Julespeak/the-spirit-board/CHANGELOG.md

# Changelog

## [1.0.0] - 2025-10-26
- First public release of the S.P.I.R.I.T. Board
- Added KiCad source files, schematic, BOM, and licensing
- Added README with reference links and photos
