Julespeak/the-spirit-board/hardware/outputs/the-spirit-board.pdf

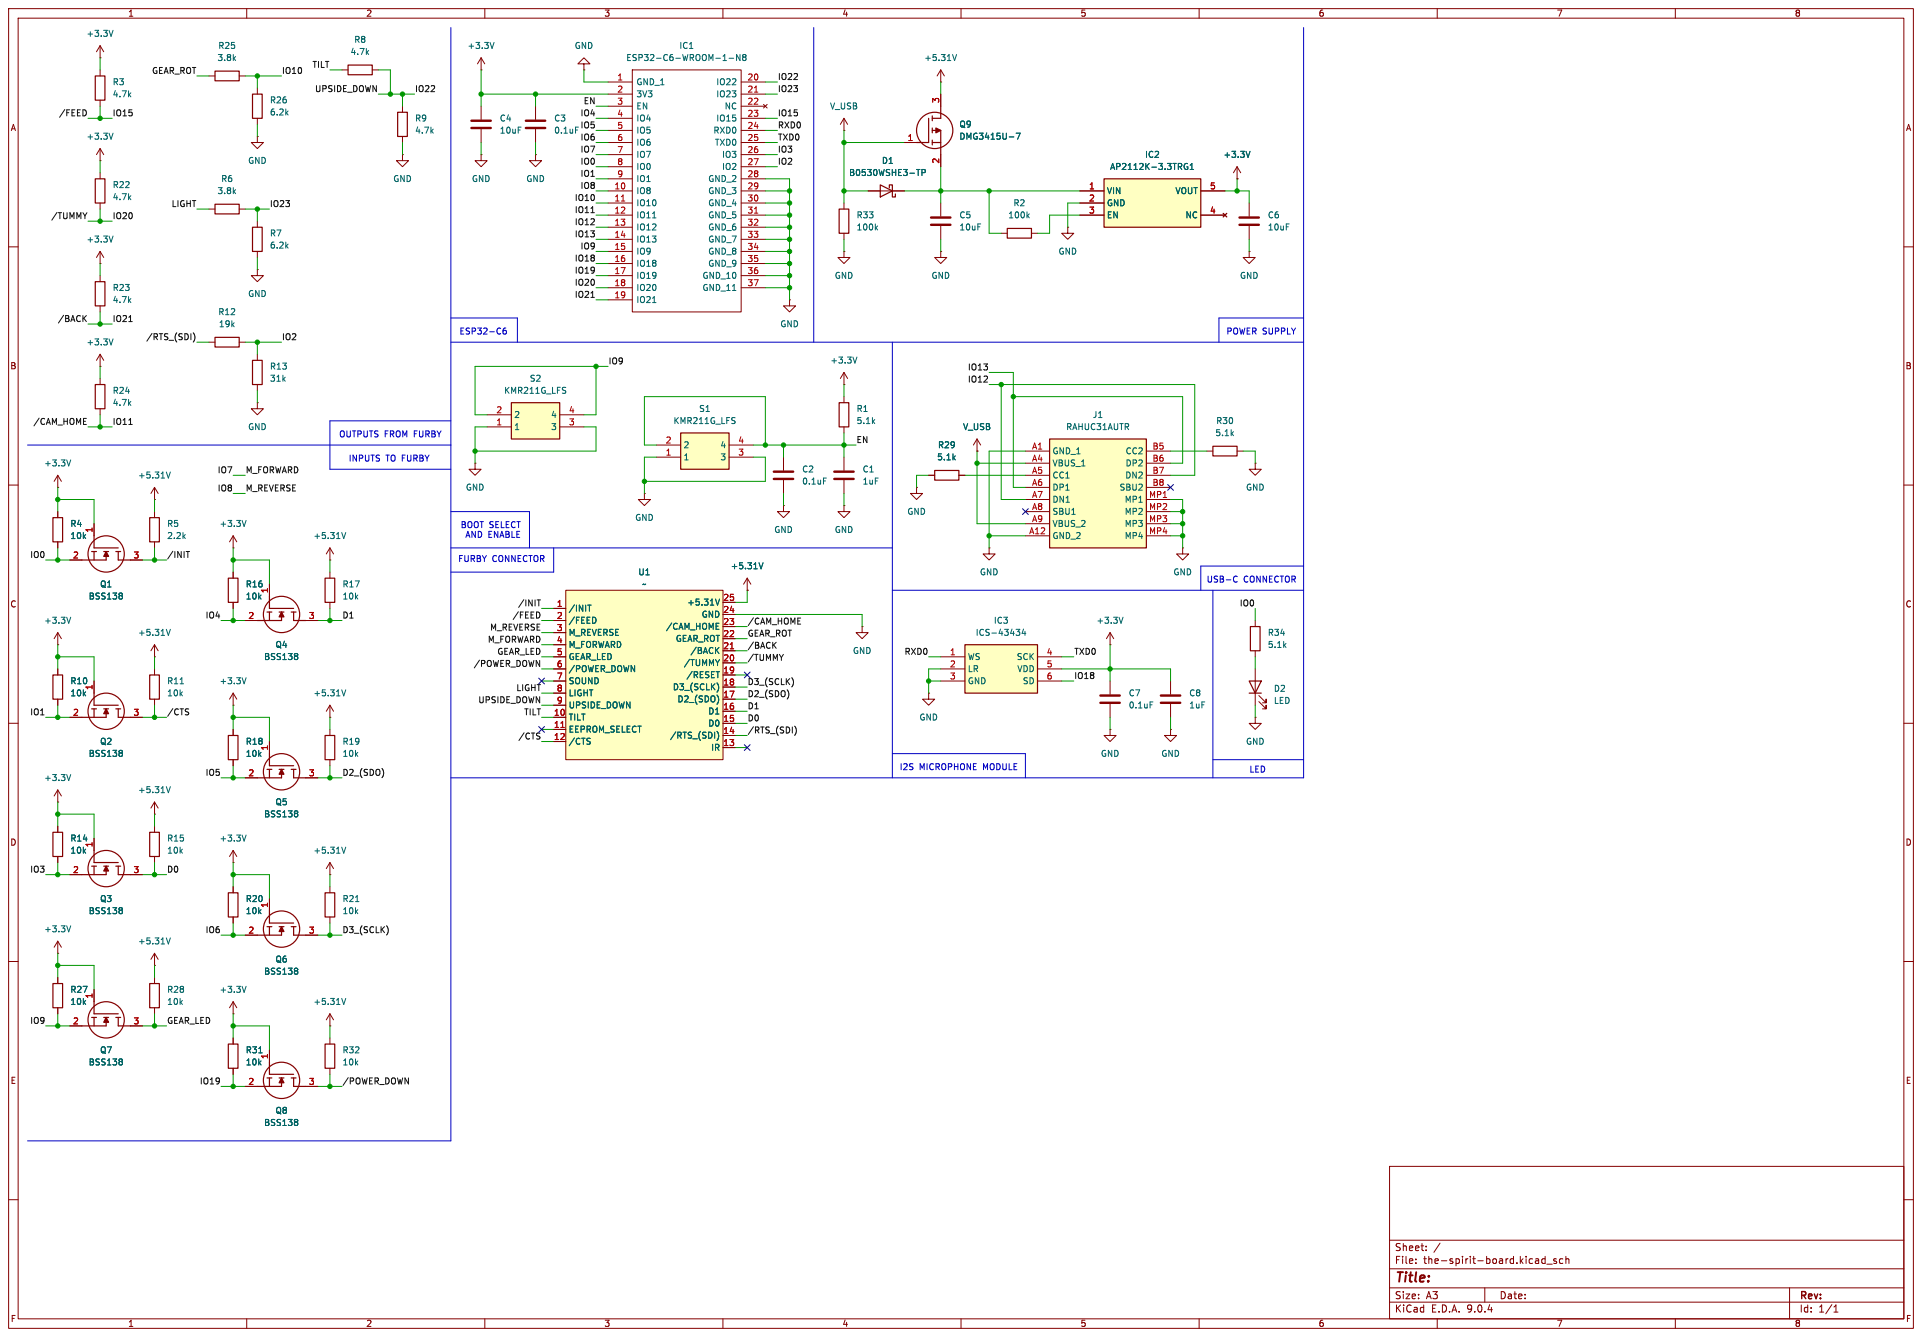
[picture p3: page 1]

BOOT SELECT AND ENABLE R20

Id: 1/1 Title: File: the-spirit-board.kicad_sch Sheet: /
