Julespeak/the-spirit-board/hardware/the-spirit-board.kicad_pcb

## KiCad design hardware/the-spirit-board.kicad_pcb (2025-10-21)

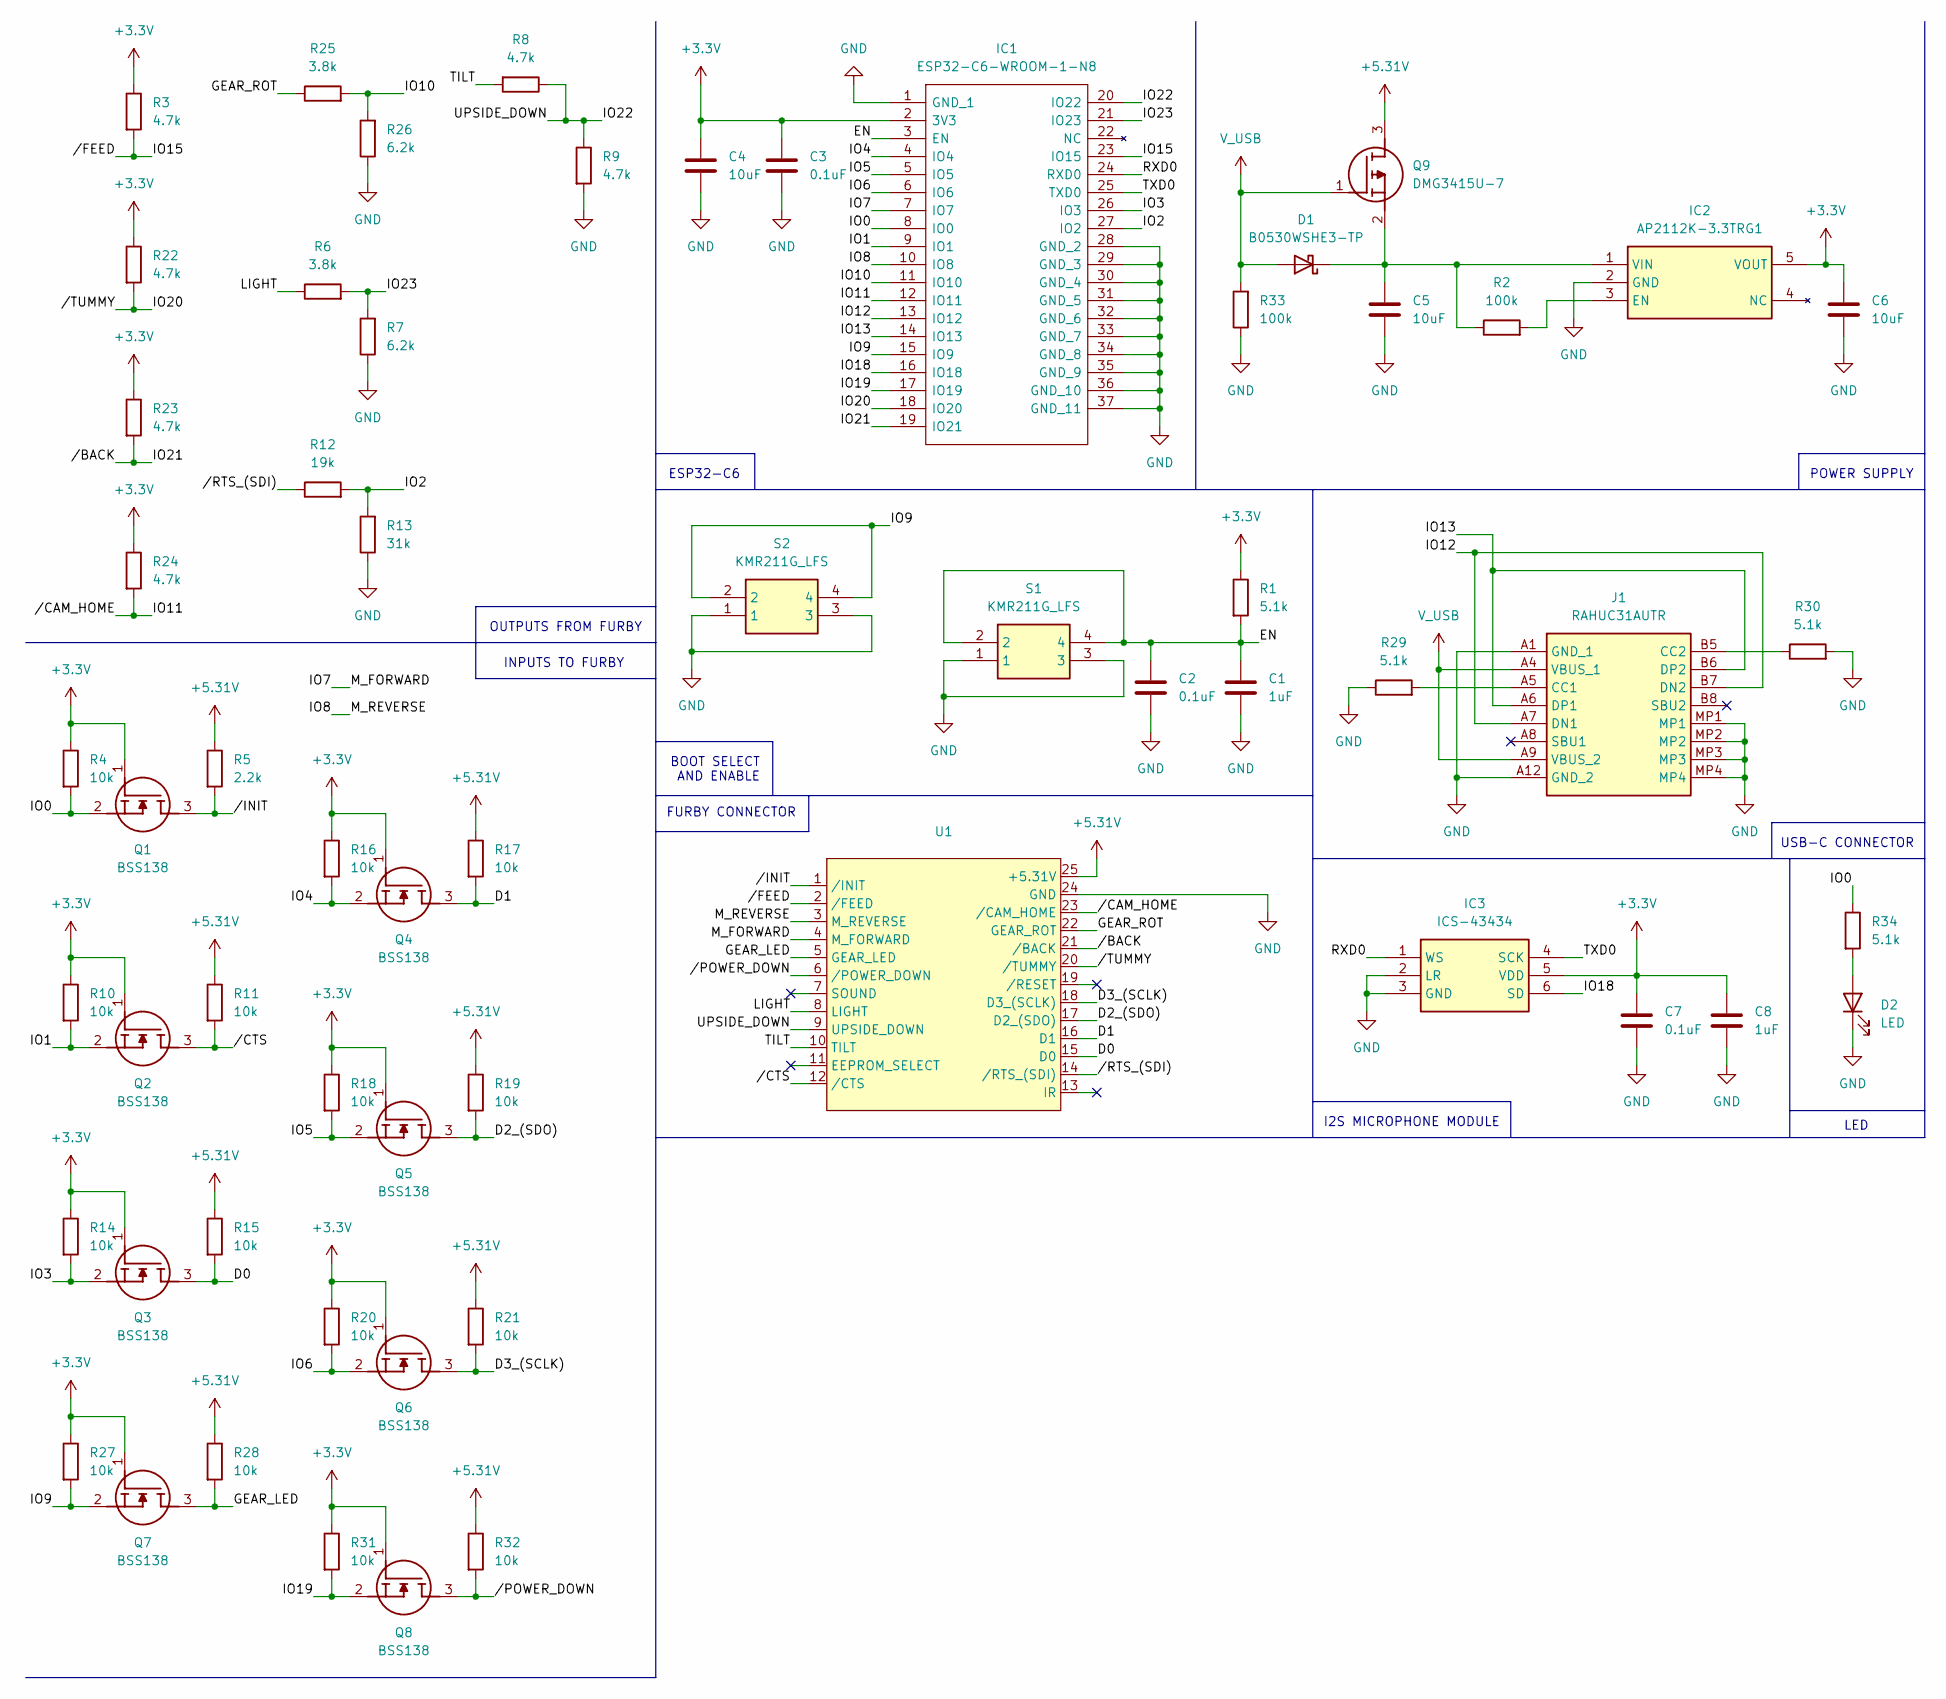
[picture p4: schematic the-spirit-board.kicad_sch]

Parts:
C1, C8: 1uF; C_0603_1608Metric; JLCPCB Part Number C15849
C2, C3: 0.1uF; C_0402_1005Metric; JLCPCB Part Number C307331
C4, C5, C6: 10uF; C_0805_2012Metric; JLCPCB Part Number C440198
C7: 0.1uF; C_0603_1608Metric; JLCPCB Part Number C14663
D1: B0530WSHE3-TP; D_SOD-323; JLCPCB Part Number C3759178
D2: LED; LED_0603_1608Metric; JLCPCB Part Number C2286
IC1: ESP32-C6-WROOM-1-N8; ESP32C6WROOM1N8; Mouser Part Number 356-ESP32C6WROOM1N8
IC2: AP2112K-3.3TRG1; SOT95P285X140-5N; Mouser Part Number 621-AP2112K-3.3TRG1
IC3: ICS-43434; ICS43434; Mouser Part Number 410-ICS-43434
J1: RAHUC31AUTR; Manufacturer_Part_Number RAHUC31AUTR; JLCPCB Part Number C21350227
Q1, Q2, Q3, Q4, Q5, Q6, Q7, Q8: BSS138; SOT95P240X120-3N; Mouser Part Number 512-BSS138
Q9: DMG3415U-7; SOT96P240X110-3N; Mouser Part Number 621-DMG3415U-7
R1, R29, R30, R34: 5.1k; R_0603_1608Metric; JLCPCB Part Number C23186
R2, R33: 100k; R_0603_1608Metric; JLCPCB Part Number C25803
R3, R8, R9, R22, R23, R24: 4.7k; R_0603_1608Metric; JLCPCB Part Number C23162
R4, R10, R11, R14, R15, R16, R17, R18, R19, R20, R21, R27, R28, R31, R32: 10k; R_0603_1608Metric; JLCPCB Part Number C25804
R5: 2.2k; R_0603_1608Metric; JLCPCB Part Number C4190
R6, R25: 3.8k; R_0603_1608Metric; JLCPCB Part Number C23018
R7, R26: 6.2k; R_0603_1608Metric; JLCPCB Part Number C4260
R12: 19k; R_0603_1608Metric; JLCPCB Part Number C25810
R13: 31k; R_0603_1608Metric; JLCPCB Part Number C22984
S1, S2: KMR211G_LFS; KMR_2; Mouser Part Number 611-KMR211G-LFS
U1: FURBY; JLCPCB Part Number N/A

Connections:
+3.3V: C3.1, C4.1, C6.2, C7.2, C8.2, IC1.2 (3V3), IC2.5 (VOUT), IC3.5 (VDD), Q1.1 (G), Q2.1 (G), Q3.1 (G), Q4.1 (G), Q5.1 (G), Q6.1 (G), Q7.1 (G), Q8.1 (G), R1.1, R3.1, R4.1, R10.1, R14.1, R16.1, R18.1, R20.1, R22.1, R23.1, R24.1, R27.1, R31.1
+5.31V: Q9.3 (D), R5.1, R11.1, R15.1, R17.1, R19.1, R21.1, R28.1, R32.1, U1.25 (+5.31V)
/D0: Q3.3 (D), R15.2, U1.15 (D0)
/D1: Q4.3 (D), R17.2, U1.16 (D1)
/D2_(SDO): Q5.3 (D), R19.2, U1.17 (D2_(SDO))
/D3_(SCLK): Q6.3 (D), R21.2, U1.18 (D3_(SCLK))
/EN: C1.1, C2.1, IC1.3 (EN), R1.2, S1.2, S1.4
/GEAR_LED: Q7.3 (D), R28.2, U1.5 (GEAR_LED)
/GEAR_ROT: R25.1, U1.22 (GEAR_ROT)
/IO0: IC1.8 (IO0), Q1.2 (S), R4.2, R34.1
/IO1: IC1.9 (IO1), Q2.2 (S), R10.2
/IO2: IC1.27 (IO2), R12.2, R13.2
/IO3: IC1.26 (IO3), Q3.2 (S), R14.2
/IO4: IC1.4 (IO4), Q4.2 (S), R16.2
/IO5: IC1.5 (IO5), Q5.2 (S), R18.2
/IO6: IC1.6 (IO6), Q6.2 (S), R20.2
/IO7: IC1.7 (IO7), U1.4 (M_FORWARD)
/IO8: IC1.10 (IO8), U1.3 (M_REVERSE)
/IO9: IC1.15 (IO9), Q7.2 (S), R27.2, S2.2, S2.4
/IO10: IC1.11 (IO10), R25.2, R26.2
/IO11: IC1.12 (IO11), R24.2, U1.23 (/CAM_HOME)
/IO12: IC1.13 (IO12), J1.A7 (DN1), J1.B7 (DN2)
/IO13: IC1.14 (IO13), J1.A6 (DP1), J1.B6 (DP2)
/IO15: IC1.23 (IO15), R3.2, U1.2 (/FEED)
/IO18: IC1.16 (IO18), IC3.6 (SD)
/IO19: IC1.17 (IO19), Q8.2 (S), R31.2
/IO20: IC1.18 (IO20), R22.2, U1.20 (/TUMMY)
/IO21: IC1.19 (IO21), R23.2, U1.21 (/BACK)
/IO22: IC1.20 (IO22), R8.1, R9.1, U1.9 (UPSIDE_DOWN)
/IO23: IC1.21 (IO23), R6.2, R7.2
/LIGHT: R6.1, U1.8 (LIGHT)
/RXD0: IC1.24 (RXD0), IC3.1 (WS)
/TILT: R8.2, U1.10 (TILT)
/TXD0: IC1.25 (TXD0), IC3.4 (SCK)
//CTS: Q2.3 (D), R11.2, U1.12 (/CTS)
//INIT: Q1.3 (D), R5.2, U1.1 (/INIT)
//POWER_DOWN: Q8.3 (D), R32.2, U1.6 (/POWER_DOWN)
//RTS_(SDI): R12.1, U1.14 (/RTS_(SDI))
GND: C1.2, C2.2, C3.2, C4.2, C5.1, C6.1, C7.1, C8.1, D2.1 (K), IC1.1 (GND_1), IC1.28 (GND_2), IC1.29 (GND_3), IC1.30 (GND_4), IC1.31 (GND_5), IC1.32 (GND_6), IC1.33 (GND_7), IC1.34 (GND_8), IC1.35 (GND_9), IC1.36 (GND_10), IC1.37 (GND_11), IC2.2 (GND), IC3.2 (LR), IC3.3 (GND), J1.A1 (GND_1), J1.A12 (GND_2), J1.MP1, J1.MP2, J1.MP3, J1.MP4, R7.1, R9.2, R13.1, R26.1, R29.1, R30.2, R33.1, S1.1, S1.3, S2.1, S2.3, U1.24 (GND)
unnamed: C5.2, D1.1 (K), IC2.1 (VIN), Q9.2 (S), R2.1
unnamed: D2.2 (A), R34.2
unnamed: IC2.3 (EN), R2.2
unnamed: J1.A5 (CC1), R29.2
unnamed: J1.B5 (CC2), R30.1
V_USB: D1.2 (A), J1.A4 (VBUS_1), J1.A9 (VBUS_2), Q9.1 (G), R33.2

Notes on the sheet:
I2S MICROPHONE MODULE
FURBY CONNECTOR
POWER SUPPLY
LED
INPUTS TO FURBY
BOOT SELECT AND ENABLE
ESP32-C6
USB-C CONNECTOR
OUTPUTS FROM FURBY

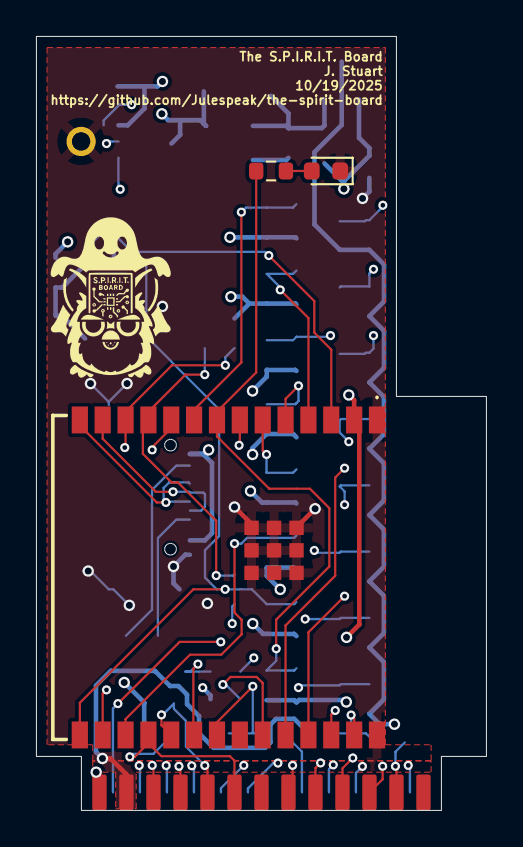
[picture p5: board the-spirit-board.kicad_pcb from above]

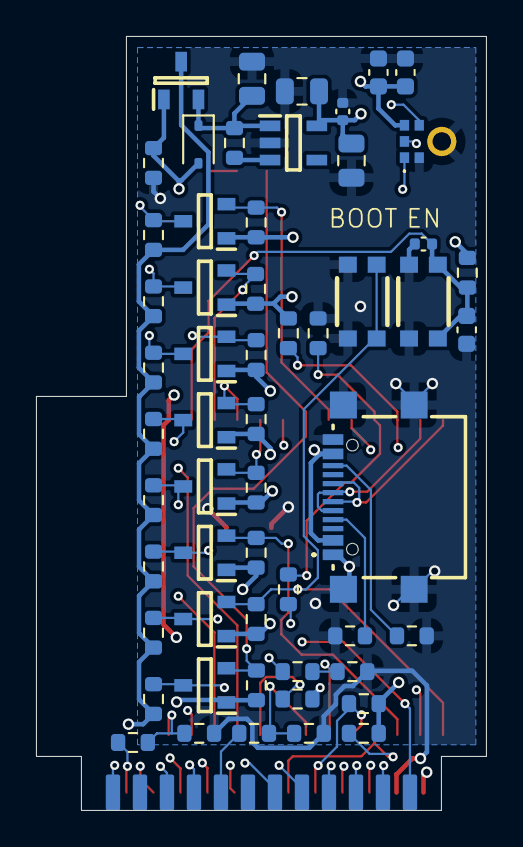
[picture p6: board the-spirit-board.kicad_pcb from below]

Board: 4 copper layers, 25.0 x 43.0 mm, 60 parts (56 on the bottom side), 45 nets.
