Julespeak/the-spirit-board/software/spirit_board.py

"""
Spirit Board Python Library

This library provides a Python interface for communicating with the Spirit Board
invoker firmware running on an ESP32. The Spirit Board is used to communicate
with Furby toys over their proprietary serial bus.

Author: Renegade Science
"""

import socket
import re
from dataclasses import dataclass
from typing import Tuple, List, Optional, Dict


# =========================
# EVENT TIMELINE TYPES
# =========================

@dataclass
class TimelineEvent:
    """
    Represents a single event in the Spirit Board timeline.

    Attributes:
        event_type: Event type code (1-9)
        event_name: Human-readable event name
        timestamp_us: Absolute timestamp in microseconds since firmware boot
        data: Event-specific data (nibble value for DATA_NIBBLE events)
    """
    event_type: int
    event_name: str
    timestamp_us: int
    data: Optional[int] = None

    def relative_time_ms(self, t0_us: int) -> float:
        """Get time relative to reference timestamp in milliseconds."""
        return (self.timestamp_us - t0_us) / 1000.0


# Event type constants matching firmware
EVENT_RTS_RISING = 0x01
EVENT_RTS_FALLING = 0x02
EVENT_CTS_RISING = 0x03
EVENT_CTS_FALLING = 0x04
EVENT_DATA_NIBBLE = 0x05
EVENT_MOTOR_FWD_ON = 0x06
EVENT_MOTOR_FWD_OFF = 0x07
EVENT_MOTOR_BWD_ON = 0x08
EVENT_MOTOR_BWD_OFF = 0x09

EVENT_NAMES = {
    EVENT_RTS_RISING: "RTS_RISE",
    EVENT_RTS_FALLING: "RTS_FALL",
    EVENT_CTS_RISING: "CTS_RISE",
    EVENT_CTS_FALLING: "CTS_FALL",
    EVENT_DATA_NIBBLE: "DATA",
    EVENT_MOTOR_FWD_ON: "MOTOR_FWD+",
    EVENT_MOTOR_FWD_OFF: "MOTOR_FWD-",
    EVENT_MOTOR_BWD_ON: "MOTOR_BWD+",
    EVENT_MOTOR_BWD_OFF: "MOTOR_BWD-",
}


class SpiritBoard:
    """
    A high-level interface for controlling the Spirit Board invoker firmware.

    The Spirit Board acts as a bridge between modern computers and the Furby
    serial bus, allowing you to send commands and control motor operations.

    Attributes:
        host (str): IP address of the ESP32 running the invoker firmware
        port (int): TCP port number (default: 5000)
        timeout (float): Socket timeout in seconds (default: 5.0)
    """

    DEFAULT_PORT = 5000
    DEFAULT_TIMEOUT = 5.0

    def __init__(self, host: str, port: int = DEFAULT_PORT, timeout: float = DEFAULT_TIMEOUT):
        """
        Initialize a Spirit Board connection.

        Args:
            host: IP address of the ESP32 (e.g., "192.168.1.100")
            port: TCP port number (default: 5000)
            timeout: Socket timeout in seconds (default: 5.0)
        """
        self.host = host
        self.port = port
        self.timeout = timeout

    def send_hex_command(self, hex_string: str) -> str:
        """
        Send a single hex command to the invoker firmware and return the response.

        This is the low-level command interface. Most users should use the
        higher-level methods like ping(), init_coprocessor(), etc.

        Args:
            hex_string: String containing hex digits (whitespace will be stripped)

        Returns:
            The entire response decoded as ASCII

        Raises:
            ValueError: If hex_string contains invalid characters
            socket.timeout: If the connection times out with no response
        """
        # Remove all whitespace so the firmware only sees hex digits
        cleaned = "".join(hex_string.split())
        if not cleaned:
            raise ValueError("hex_string must contain at least one hex digit")

        # Basic validation: all characters must be hex
        for ch in cleaned:
            if ch not in "0123456789abcdefABCDEF":
                raise ValueError(f"Invalid hex character {ch!r} in {hex_string!r}")

        data = (cleaned + "\n").encode("ascii")

        with socket.socket(socket.AF_INET, socket.SOCK_STREAM) as s:
            s.settimeout(self.timeout)
            s.connect((self.host, self.port))
            s.sendall(data)

            chunks = []
            while True:
                try:
                    chunk = s.recv(1024)
                except socket.timeout:
                    # If we've already got something, return it; otherwise, report timeout
                    if chunks:
                        break
                    return "[NO RESPONSE - socket timeout]"
                if not chunk:
                    break
                chunks.append(chunk)

        resp = b"".join(chunks)
        return resp.decode("ascii", errors="replace").strip()

    def ping(self) -> str:
        """
        Ping the invoker firmware to verify connectivity.

        Returns:
            The ASCII string '31337' if the firmware is responding correctly
        """
        # Control byte 0xFF, no payload
        return self.send_hex_command("FF")

    def init_coprocessor(self) -> str:
        """
        Pulse /INIT low for 10 ms to reset the Furby coprocessor.

        This should be called before sending command sequences to ensure
        the Furby is in a known state.

        Returns:
            Firmware status string
        """
        # Control byte 0x01, no payload required
        return self.send_hex_command("01")

    def send_nibble_stream(self, nibble_hex: str) -> str:
        """
        Send an arbitrary nibble stream to the Furby bus.

        Each character in nibble_hex represents a 4-bit nibble that will be
        sent over the Furby serial bus. This is the primary method for
        sending commands to make the Furby perform actions.

        Args:
            nibble_hex: String of hex digits representing successive 4-bit nibbles
                       (e.g., "F7F347F7F71C000000000000F000FFFFFF")

        Returns:
            Firmware response including nibble echo and timing information
        """
        # Control byte 0x02 + nibble payload
        return self.send_hex_command("02" + nibble_hex)

    def _format_duration_us(self, duration_us: int) -> str:
        """
        Format a duration in microseconds as a 16-hex-digit big-endian 64-bit value.

        Args:
            duration_us: Duration in microseconds (non-negative)

        Returns:
            16 uppercase hex digits (e.g., 1_000_000 -> '00000000000F4240')

        Raises:
            ValueError: If duration_us is negative
        """
        if duration_us < 0:
            raise ValueError("duration_us must be non-negative")
        # Mask to 64 bits and format as 16 uppercase hex digits
        return f"{int(duration_us) & ((1 << 64) - 1):016X}"

    def motor_forward(self, duration_us: int) -> str:
        """
        Drive the Furby motor forward for a specified duration.

        Args:
            duration_us: Duration in microseconds (e.g., 1_000_000 for 1 second)

        Returns:
            Firmware response
        """
        payload = self._format_duration_us(duration_us)
        # Control byte 0x03 + 64-bit duration payload
        return self.send_hex_command("03" + payload)

    def motor_backward(self, duration_us: int) -> str:
        """
        Drive the Furby motor backward for a specified duration.

        Args:
            duration_us: Duration in microseconds (e.g., 1_000_000 for 1 second)

        Returns:
            Firmware response
        """
        payload = self._format_duration_us(duration_us)
        # Control byte 0x04 + 64-bit duration payload
        return self.send_hex_command("04" + payload)

    def get_rts_timing(self) -> str:
        """
        Read the event timeline from the firmware.

        This returns detailed timing information about all bus events during
        the last operation (nibble stream, initialization, etc.). Includes
        RTS/CTS edges, data nibbles, and motor events with microsecond timestamps.

        Use parse_timeline() to convert the response into structured data.

        Returns:
            Timeline data as a string (use parse_timeline() to parse)

        Example:
            >>> events = parse_timeline(board.get_rts_timing())
            >>> print(render_timeline(events, max_events=20))
        """
        # Control byte 0x05, no payload
        return self.send_hex_command("05")


def parse_nibble_echo(response: str) -> Tuple[int, List[int]]:
    """
    Parse a firmware response containing a nibble echo.

    The firmware responds with a line like:
        [NIBBLES] count=24 : 7,F,3,4,1,F,...

    This function extracts the count and nibble values from that response.

    Args:
        response: Firmware response string

    Returns:
        Tuple of (count, list of nibble values as integers)

    Raises:
        ValueError: If the response doesn't contain a valid [NIBBLES] line

    Example:
        >>> parse_nibble_echo("[NIBBLES] count=4 : F,7,3,4")
        (4, [15, 7, 3, 4])
    """
    lines = response.splitlines()
    nib_line = None
    for line in lines:
        if line.startswith("[NIBBLES]"):
            nib_line = line
            break
    if nib_line is None:
        raise ValueError(f"No [NIBBLES] line found in response: {response!r}")

    # Rough parse: extract the 'count=' number and the stuff after ':'
    m = re.search(r"count\s*=\s*(\d+)\s*:\s*(.*)", nib_line)
    if not m:
        raise ValueError(f"Could not parse [NIBBLES] line: {nib_line!r}")

    count = int(m.group(1))
    tail = m.group(2).strip()

    nibs = []
    if tail:
        for part in tail.split(","):
            part = part.strip()
            if not part:
                continue
            # Interpret as hex (so 'F' -> 15, '0' -> 0, 'A' -> 10, etc.)
            nibs.append(int(part, 16))

    return count, nibs


def parse_timeline(response: str) -> List[TimelineEvent]:
    """
    Parse firmware timeline response into structured event list.

    The firmware responds with a line like:
        [TIMELINE] 12 events: 5,0,1A2B3C4D,7;1,0,1A2B3C55;...

    Format for each event:
        - Type,TimestampHi,TimestampLo[,Data]
        - Events separated by semicolons
        - DATA_NIBBLE events include nibble value as 4th field

    Args:
        response: Firmware response string

    Returns:
        List of TimelineEvent objects in chronological order

    Raises:
        ValueError: If response doesn't contain valid [TIMELINE] data

    Example:
        >>> events = parse_timeline(board.get_rts_timing())
        >>> print(f"Captured {len(events)} events")
        >>> print(f"First event: {events[0].event_name} at {events[0].timestamp_us}us")
    """
    lines = response.splitlines()
    timeline_line = None
    for line in lines:
        if line.startswith("[TIMELINE]"):
            timeline_line = line
            break

    if timeline_line is None:
        raise ValueError(f"No [TIMELINE] line found in response: {response!r}")

    # Parse: [TIMELINE] N events: data...
    m = re.search(r'\[TIMELINE\]\s+(\d+)\s+events:\s*(.*)', timeline_line)
    if not m:
        raise ValueError(f"Could not parse [TIMELINE] line: {timeline_line!r}")

    count = int(m.group(1))
    data = m.group(2).strip()

    if count == 0 or data == "none":
        return []

    events = []
    event_strs = data.split(';')

    for evt_str in event_strs:
        evt_str = evt_str.strip()
        if not evt_str:
            continue

        parts = evt_str.split(',')
        if len(parts) < 3:
            raise ValueError(f"Invalid event format: {evt_str!r}")

        # Parse event type
        event_type = int(parts[0], 16)

        # Parse 64-bit timestamp from two 32-bit hex values
        timestamp_hi = int(parts[1], 16)
        timestamp_lo = int(parts[2], 16)
        timestamp_us = (timestamp_hi << 32) | timestamp_lo

        # Parse optional data field (for DATA_NIBBLE events)
        data_val = None
        if len(parts) >= 4:
            data_val = int(parts[3], 16)

        event_name = EVENT_NAMES.get(event_type, f"UNKNOWN_{event_type:02X}")

        events.append(TimelineEvent(
            event_type=event_type,
            event_name=event_name,
            timestamp_us=timestamp_us,
            data=data_val
        ))

    return events


def render_timeline(events: List[TimelineEvent],
                    show_absolute: bool = False,
                    max_events: Optional[int] = None) -> str:
    """
    Render timeline events as human-readable text table.

    Args:
        events: List of TimelineEvent objects
        show_absolute: If True, show absolute timestamps; if False, show relative to first event
        max_events: Maximum number of events to display (None = all)

    Returns:
        Formatted string representation of timeline

    Example:
        >>> events = parse_timeline(board.get_rts_timing())
        >>> print(render_timeline(events, max_events=20))
    """
    if not events:
        return "No events in timeline"

    t0 = events[0].timestamp_us if not show_absolute else 0

    lines = []
    lines.append(f"Timeline: {len(events)} events")
    lines.append("-" * 80)

    if show_absolute:
        lines.append(f"{'Index':<6} {'Time (us)':<20} {'Δt (ms)':<12} {'Event':<15} {'Data'}")
    else:
        lines.append(f"{'Index':<6} {'Δt (ms)':<12} {'Event':<15} {'Data'}")
    lines.append("-" * 80)

    display_events = events[:max_events] if max_events else events
    prev_time = t0

    for idx, evt in enumerate(display_events):
        rel_time_ms = (evt.timestamp_us - t0) / 1000.0
        delta_ms = (evt.timestamp_us - prev_time) / 1000.0

        data_str = ""
        if evt.event_type == EVENT_DATA_NIBBLE and evt.data is not None:
            data_str = f"0x{evt.data:X}"

        if show_absolute:
            lines.append(f"{idx:<6} {evt.timestamp_us:<20} {delta_ms:<12.3f} {evt.event_name:<15} {data_str}")
        else:
            lines.append(f"{idx:<6} {rel_time_ms:<12.3f} {evt.event_name:<15} {data_str}")

        prev_time = evt.timestamp_us

    if max_events and len(events) > max_events:
        lines.append(f"... ({len(events) - max_events} more events)")

    return "\n".join(lines)


def plot_timeline(events: List[TimelineEvent],
                  title: str = "Spirit Board Event Timeline",
                  figsize: Tuple[int, int] = (14, 8),
                  show_nibbles: bool = True):
    """
    Create matplotlib visualization of timeline events.

    Generates a multi-track timeline showing:
    - RTS signal state over time
    - CTS signal state over time
    - Data nibble values
    - Motor events

    Args:
        events: List of TimelineEvent objects
        title: Plot title
        figsize: Figure size (width, height) in inches
        show_nibbles: If True, display nibble values on data track

    Returns:
        tuple: (figure, axes) matplotlib objects

    Example:
        >>> import matplotlib.pyplot as plt
        >>> events = parse_timeline(board.get_rts_timing())
        >>> fig, axes = plot_timeline(events)
        >>> plt.show()
    """
    try:
        import matplotlib.pyplot as plt
        import matplotlib.patches as mpatches
    except ImportError:
        raise ImportError("matplotlib required for timeline visualization. Install with: pip install matplotlib")

    if not events:
        raise ValueError("No events to plot")

    # Convert to relative time in milliseconds
    t0 = events[0].timestamp_us
    times_ms = [(e.timestamp_us - t0) / 1000.0 for e in events]

    # Create figure with 4 tracks: RTS, CTS, DATA, MOTOR
    fig, axes = plt.subplots(4, 1, figsize=figsize, sharex=True)
    fig.suptitle(title, fontsize=14, fontweight='bold')

    # Track 1: RTS signal
    ax_rts = axes[0]
    rts_state = 0  # Start LOW
    rts_times = [0]
    rts_values = [0]

    for i, evt in enumerate(events):
        if evt.event_type == EVENT_RTS_RISING:
            rts_state = 1
            rts_times.extend([times_ms[i], times_ms[i]])
            rts_values.extend([0, 1])
        elif evt.event_type == EVENT_RTS_FALLING:
            rts_state = 0
            rts_times.extend([times_ms[i], times_ms[i]])
            rts_values.extend([1, 0])

    # Extend to end
    rts_times.append(times_ms[-1] if times_ms else 0)
    rts_values.append(rts_state)

    ax_rts.plot(rts_times, rts_values, 'b-', linewidth=2, label='RTS')
    ax_rts.fill_between(rts_times, 0, rts_values, alpha=0.3, color='blue')
    ax_rts.set_ylabel('RTS', fontweight='bold')
    ax_rts.set_ylim(-0.1, 1.1)
    ax_rts.grid(True, alpha=0.3)
    ax_rts.set_yticks([0, 1])
    ax_rts.set_yticklabels(['LOW', 'HIGH'])

    # Track 2: CTS signal
    ax_cts = axes[1]
    cts_state = 1  # Start HIGH (idle)
    cts_times = [0]
    cts_values = [1]

    for i, evt in enumerate(events):
        if evt.event_type == EVENT_CTS_RISING:
            cts_state = 1
            cts_times.extend([times_ms[i], times_ms[i]])
            cts_values.extend([0, 1])
        elif evt.event_type == EVENT_CTS_FALLING:
            cts_state = 0
            cts_times.extend([times_ms[i], times_ms[i]])
            cts_values.extend([1, 0])

    cts_times.append(times_ms[-1] if times_ms else 0)
    cts_values.append(cts_state)

    ax_cts.plot(cts_times, cts_values, 'g-', linewidth=2, label='CTS')
    ax_cts.fill_between(cts_times, 0, cts_values, alpha=0.3, color='green')
    ax_cts.set_ylabel('CTS', fontweight='bold')
    ax_cts.set_ylim(-0.1, 1.1)
    ax_cts.grid(True, alpha=0.3)
    ax_cts.set_yticks([0, 1])
    ax_cts.set_yticklabels(['LOW', 'HIGH'])

    # Track 3: Data nibbles
    ax_data = axes[2]
    data_events = [e for e in events if e.event_type == EVENT_DATA_NIBBLE]

    if data_events:
        data_times = [(e.timestamp_us - t0) / 1000.0 for e in data_events]
        data_values = [e.data if e.data is not None else 0 for e in data_events]

        ax_data.scatter(data_times, data_values, c='red', s=50, marker='o', alpha=0.7)
        ax_data.step(data_times, data_values, 'r-', where='post', alpha=0.5)

        if show_nibbles:
            for t, v in zip(data_times, data_values):
                ax_data.text(t, v + 0.3, f"{v:X}", fontsize=8, ha='center', va='bottom')

    ax_data.set_ylabel('Data\nNibbles', fontweight='bold')
    ax_data.set_ylim(-0.5, 15.5)
    ax_data.grid(True, alpha=0.3)
    ax_data.set_yticks(range(0, 16, 2))

    # Track 4: Motor events
    ax_motor = axes[3]
    motor_fwd_intervals = []
    motor_bwd_intervals = []

    fwd_start = None
    bwd_start = None

    for i, evt in enumerate(events):
        if evt.event_type == EVENT_MOTOR_FWD_ON:
            fwd_start = times_ms[i]
        elif evt.event_type == EVENT_MOTOR_FWD_OFF and fwd_start is not None:
            motor_fwd_intervals.append((fwd_start, times_ms[i]))
            fwd_start = None
        elif evt.event_type == EVENT_MOTOR_BWD_ON:
            bwd_start = times_ms[i]
        elif evt.event_type == EVENT_MOTOR_BWD_OFF and bwd_start is not None:
            motor_bwd_intervals.append((bwd_start, times_ms[i]))
            bwd_start = None

    for start, end in motor_fwd_intervals:
        ax_motor.axvspan(start, end, alpha=0.5, color='orange', label='Forward' if not ax_motor.patches else '')

    for start, end in motor_bwd_intervals:
        ax_motor.axvspan(start, end, alpha=0.5, color='purple', label='Backward' if not ax_motor.patches else '')

    ax_motor.set_ylabel('Motor', fontweight='bold')
    ax_motor.set_ylim(0, 1)
    ax_motor.grid(True, alpha=0.3)
    ax_motor.set_yticks([])
    if motor_fwd_intervals or motor_bwd_intervals:
        ax_motor.legend(loc='upper right')

    ax_motor.set_xlabel('Time (ms)', fontweight='bold')

    plt.tight_layout()
    return fig, axes


# Predefined Furby command sequences
# These are known command sequences captured from actual Furby communication
FURBY_COMMANDS = {
    "init": "F7F347F7F71C000000000000000000000000F000FFFFFF",

    "yawn": "F7F326F7F719000000000000000000000000F000FFFFFF50F15592CD6DDA077490BEBA41DC4AF864B44753D99C51A6240E3B172990654B2CD27D344F7286A85567788E255532BAC2F80D292BD275A2E15C465D156E87D34BA02AA9FBC2B7765D5353B9856FC6EAA8D4531BCF6146896AB6369F037C935BAB8C3317F835B66B01A6CB2D2F2DCE025D981A1E5E8D343A3BB4B3D30B7884866977B516611D55A6EC772CE332BA55C9FD48C91574AA1CF790836A195529EF21FEC34E9C52CF52ADA4142DC08FD43C6F49B2710FF9897E8565B21E744364EA0B752CE99258D946F358B3D4922C84F9A07B29194928EB5117D136C08ECFC26E93DC9D2D8F954C1DB9C2710FBB872E7F74351EE70BA4A08CFA3CC03ED811CCFF6653FCA13AC86FCC5AA8C83893DE910D5BA294B0AC5399941D65E14BD6B2C85794EB4E1E6BED8F37891CBCFA1CE6761B386B8DAA98619E70291A629AB29DFC1AE5A415B4BAF92DBBE148B67704DA55D2C8DDEEF7B9689623B1DD70620D3B4471A361B09AA866E546C18E365980848CA55DA1341A139943EA97B925AC2BBE4633835C1B0069714D04D1596F0F00FFFFFF",

    "sequence-0": "F7F341F7F71C0000F000FFFFFF005000BBD65404036C1706C056DBC26B6C134876A61E4583B6B053D12C9907ECA9AEDC5A41BDDA5CD5BBA4A23BB3B9BB67493D67777367DE822BCB2FAACEAD15C88DDDC49D8A7B96BA89A729080001605516CC1035ACE811FEC5EE8E6FD5122E8EA555BEAD14EC414BA29D0B78D97E59267B00300004875A46B52E6E39D0AD7C7B493F62B2DFE0EE2F238833AFC16E1464C6D94F735C225C8B9D8AB68698AB16B90DEC49E04F9E33138A3BD990E49D368D34D522A9A95C8F98955398D3B80F2EE23DD0BF715E3D2616326F134D4A5B0C9C8E37BB78A616670050E857BBCA6CF2C731BE6766C0D5AF526DF24E99B54F74CBD99A33BB867897FA21B8E61DE04FD45EA1DC28D3EEA72DE2B740CB9D018BD2E2A09798BAE277B3512F1FAED05F49F2DD246BA25682F59B74C5270D0DFCF6F0857AA61AEAEDF1C229BC32D704E38DD9A974A347C92CD143E8271B9748A39ED15E347780572DB3AC68EE01D64A7749D8BD02BD847E90F16D12EA19EC25F3CA34D632C902F88578AD7493C4DB1BF0CAE84F1AB346B194F15E25DF4CE60D359AA83F907D41AB539F0A64E61ABD7BB7B831A122A2F57FD4954A4491DAFDC234C48473F4EB8765790800FFFFFFF7F347F7F71D04C0AA25C830C3E128007DA10208837D3102E047CB8830C8BA24003EB48C08939CEE26D70B9794E2FC38B1BE22A86DBB44872DA860BCEB8817DB493175CE013EC903A1EE6DB2FC538444BE0A3AD88114AA6B297B53895C7BD611E67B966466ED02B163539CF2E3450C79E61BEEAB9A14E6DE36C7BF59106DAD6CAF3FC430B947313F4D4013652DE1AE275127DA2810A7228808F6926902A14B419C77E3450679D62AE9D79A14E2DD54D5772320DD6BA89F6F5A30BB476937CE6C90679EE27E588826CE0B16EC6E116595467CE92512C86B9CF8B3C934915639E19705582FBC62C74F1D205E6BD097DE2870BBC2C13FBC40F2695CD3AD0599674E4638A918445E6BCFFFFFFFF7F3C3F7F71C00000000000000000000000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

}


def get_furby_command(command_name: str) -> Optional[str]:
    """
    Get a predefined Furby command sequence by name.

    Args:
        command_name: Name of the command (e.g., "init", "yawn", "giggle")

    Returns:
        Hex string for the command, or None if not found

    Example:
        >>> cmd = get_furby_command("init")
        >>> board.send_nibble_stream(cmd)
    """
    return FURBY_COMMANDS.get(command_name.lower())


def list_furby_commands() -> List[str]:
    """
    Get a list of all available predefined Furby command names.

    Returns:
        List of command names
    """
    return sorted(FURBY_COMMANDS.keys())
