Julespeak/the-spirit-board/(commit log)

2025-05-18 Fix a filetype issue due to new KiCAD version
2025-06-14 Initial commit of the schematic and board files with the ESP32
    [the-spirit-board.kicad_pcb, the-spirit-board.kicad_sch]
2025-08-16 Add power supply and momentary switch for enable
    [the-spirit-board.kicad_pcb, the-spirit-board.kicad_sch]
2025-08-16 Add the footprint for the Furby and do initial connections
    [the-spirit-board.kicad_pcb, the-spirit-board.kicad_sch]
2025-09-16 Update the schematic symbol for the Furby main board connection
    [the-spirit-board.kicad_sch]
2025-09-17 Completed connection between the Furby and the ESP32-C6
    [the-spirit-board.kicad_pcb, the-spirit-board.kicad_sch]
2025-09-24 Add USB-C connection
    [the-spirit-board.kicad_pcb, the-spirit-board.kicad_sch]
2025-09-27 Add an I2S microphone module
    [the-spirit-board.kicad_pcb, the-spirit-board.kicad_sch]
2025-09-27 Initial draft of the schematic complete
    [the-spirit-board.kicad_pcb, the-spirit-board.kicad_sch]
2025-10-09 Update the size of the board based on new measurements of the Furby chassis
2025-10-09 Update the USB connector 3D model
2025-10-09 Update the keepout area on the ESP footprint
2025-10-09 Lots of updates to the PCB; all connections made except for one diode; working on passing DRC; targeting 4pcb
    [the-spirit-board.kicad_pcb, the-spirit-board.kicad_sch]
2025-10-09 Add PDF of the schematic
2025-10-19 Update the diode in the power supply
    [the-spirit-board.kicad_pcb, the-spirit-board.kicad_sch]
2025-10-20 Update the schematic and layout after choosing parts
    [the-spirit-board.kicad_pcb, the-spirit-board.kicad_sch]
2025-10-20 First take at gerber outputs
    [the-spirit-board-B_Cu.gbl, the-spirit-board-B_Mask.gbs, the-spirit-board-B_Paste.gbp, the-spirit-board-B_Silkscreen.gbo, the-spirit-board-Edge_Cuts.gm1, the-spirit-board-F_Cu.gtl, the-spirit-board-F_Mask.gts, the-spirit-board-F_Paste.gtp]
2025-10-21 Update gerbers, BOM, and placement for JLCPCB
    [the-spirit-board-B_Cu.gbl, the-spirit-board-B_Mask.gbs, the-spirit-board-B_Paste.gbp, the-spirit-board-B_Silkscreen.gbo, the-spirit-board-Edge_Cuts.gm1, the-spirit-board-F_Cu.gtl, the-spirit-board-F_Mask.gts, the-spirit-board-F_Paste.gtp]
2025-10-21 Update the placement file to a single file for top and bottom
    [the-spirit-board-all-pos.csv, the-spirit-board-top-pos.csv]
2025-10-26 Add board images
2025-12-08 Split the repo into hardware and firmware; initial commit of the invoker firmware
    [the-spirit-board-B_Cu.gbl, the-spirit-board-B_Mask.gbs, the-spirit-board-B_Paste.gbp, the-spirit-board-B_Silkscreen.gbo, the-spirit-board-Edge_Cuts.gm1, the-spirit-board-F_Cu.gtl, the-spirit-board-F_Mask.gts, the-spirit-board-F_Paste.gtp]
2025-12-28 Add some new debug sequences, re-tool the sendNibble function to have the correct RTS/CTS handshake, fix a pullup issue with RTS
    [invoker.ino]
2026-01-01 Add Claude to the project along with all context files; add jupyter notebooks and refactor into a library for interacting with the spirit board
2026-01-06 Update the firmware to include some additional delays to try and fix a presumed timing issue; these updates did not improve comms but are good practice
    [invoker.ino]
2026-01-06 Add event timeline data structures to firmware
    - Add EventType enum with 9 event types (RTS/CTS edges, data nibbles, motor events)
    - Add TimelineEvent struct with event_type, data, and 64-bit timestamp
    - Replace RTS history buffer with timeline buffer (5000 events, ~45KB)
    - Add recordEvent() function and convenience wrappers
    - Include esp_timer.h for esp_timer_get_time()
    This is Phase 1 of the event timeline feature - data structures only,
    no breaking changes yet.
    [invoker.ino]
2026-01-06 Add event logging to all timing-critical firmware functions
    - sendNibble(): Log DATA, CTS_FALL, RTS_RISE, CTS_RISE, RTS_FALL
    - doInitCoprocessor(): Log RTS_RISE/RTS_FALL edges during init
    - driveMotorForward/Backward(): Log MOTOR_*_ON/OFF events
    - sendNibbleList(): Use clearTimeline() instead of clearRTSHistory()
    All timeline events are recorded with microsecond timestamps from
    esp_timer_get_time() for precise timing analysis.
    This is Phase 2 - event logging is now active, but command 0x05 still
    returns old format (to be updated in Phase 3).
2026-01-06 BREAKING: Replace command 0x05 with timeline format
    Replace RTS-only timing with complete event timeline for both command
    0x01 (init) and 0x05 (read timing).
    Response format changed from:
    [RTS] N samples: dur1,dur2,...
    To:
    [TIMELINE] N events: type,ts_hi,ts_lo[,data];...
    Where:
    - type: Event type code (01-09 in hex)
    - ts_hi/ts_lo: 64-bit timestamp split into two 32-bit hex values
    - data: Optional nibble value for DATA events
    This is a breaking change - existing Python code using get_rts_timing()
    will need to be updated to use parse_timeline().
    Updated firmware header comments to reflect new command 0x05 behavior.
    Co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
    [invoker.ino]
2026-01-06 Add Python library functions for timeline analysis
    - Add TimelineEvent dataclass with event_type, event_name, timestamp_us, data
    - Add event type constants (EVENT_RTS_RISING, EVENT_CTS_FALLING, etc.)
    - Add parse_timeline() to parse firmware [TIMELINE] responses
    - Add render_timeline() for text table output
    - Add plot_timeline() for matplotlib 4-track visualization (RTS, CTS, DATA, MOTOR)
    - Update get_rts_timing() docstring with new usage examples
    The Python library now provides complete timeline parsing and visualization
    capabilities for debugging Furby bus communication.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
2026-01-20 Add RGB LED control to the Feather target
2026-01-21 Reduce the audio sample length to save RAM
2026-02-01 Add the audio capture to the main spirit firmware; update notebooks; implement PlatformIO workflow for spirit board
